Amir7698/desk-clock-pcb/docs/desk-clock-schematic.pdf

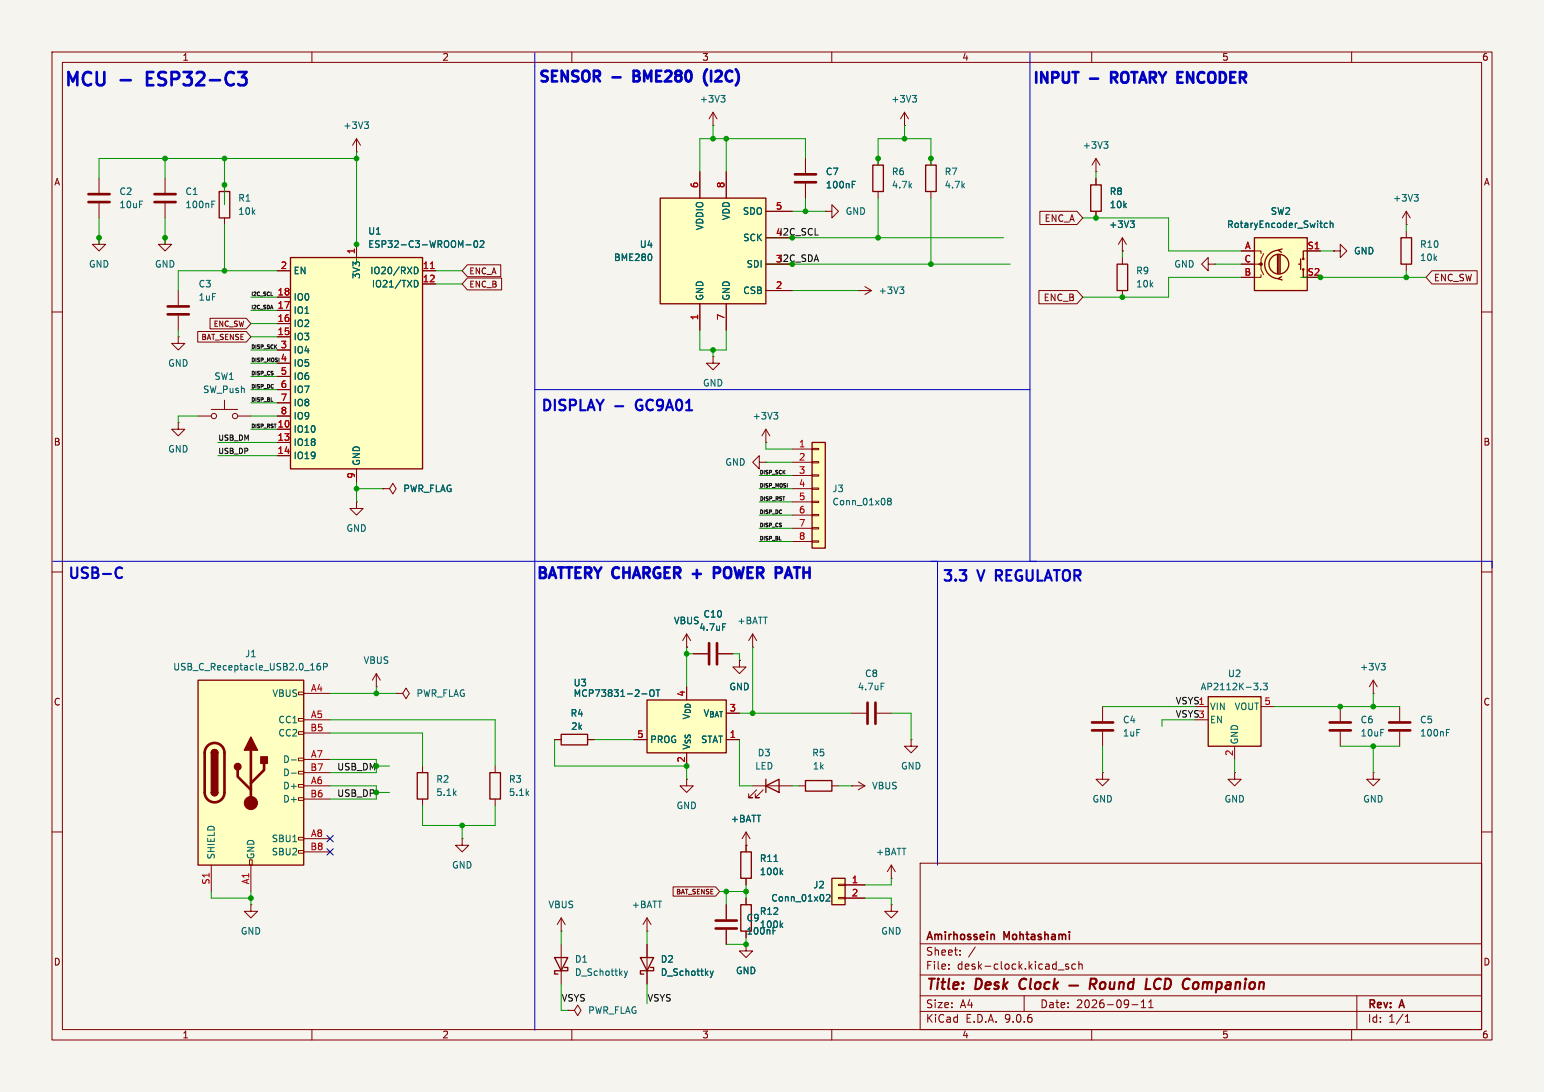
[picture p4: page 1]

7 SDO 5 SCK 4 SDI 3 CSB 2 U4 BME280 R3

7 SDO 5 SCK 4 SDI 3 CSB 2 D2 D_Schottky GND

BATTERY CHARGER + POWER PATH

Id: 1/1 Title: Desk Clock þÿ Round LCD Companion
