Amir7698/desk-clock-pcb/desk-clock.kicad_pcb

## KiCad design desk-clock.kicad_pcb (2026-10-23)

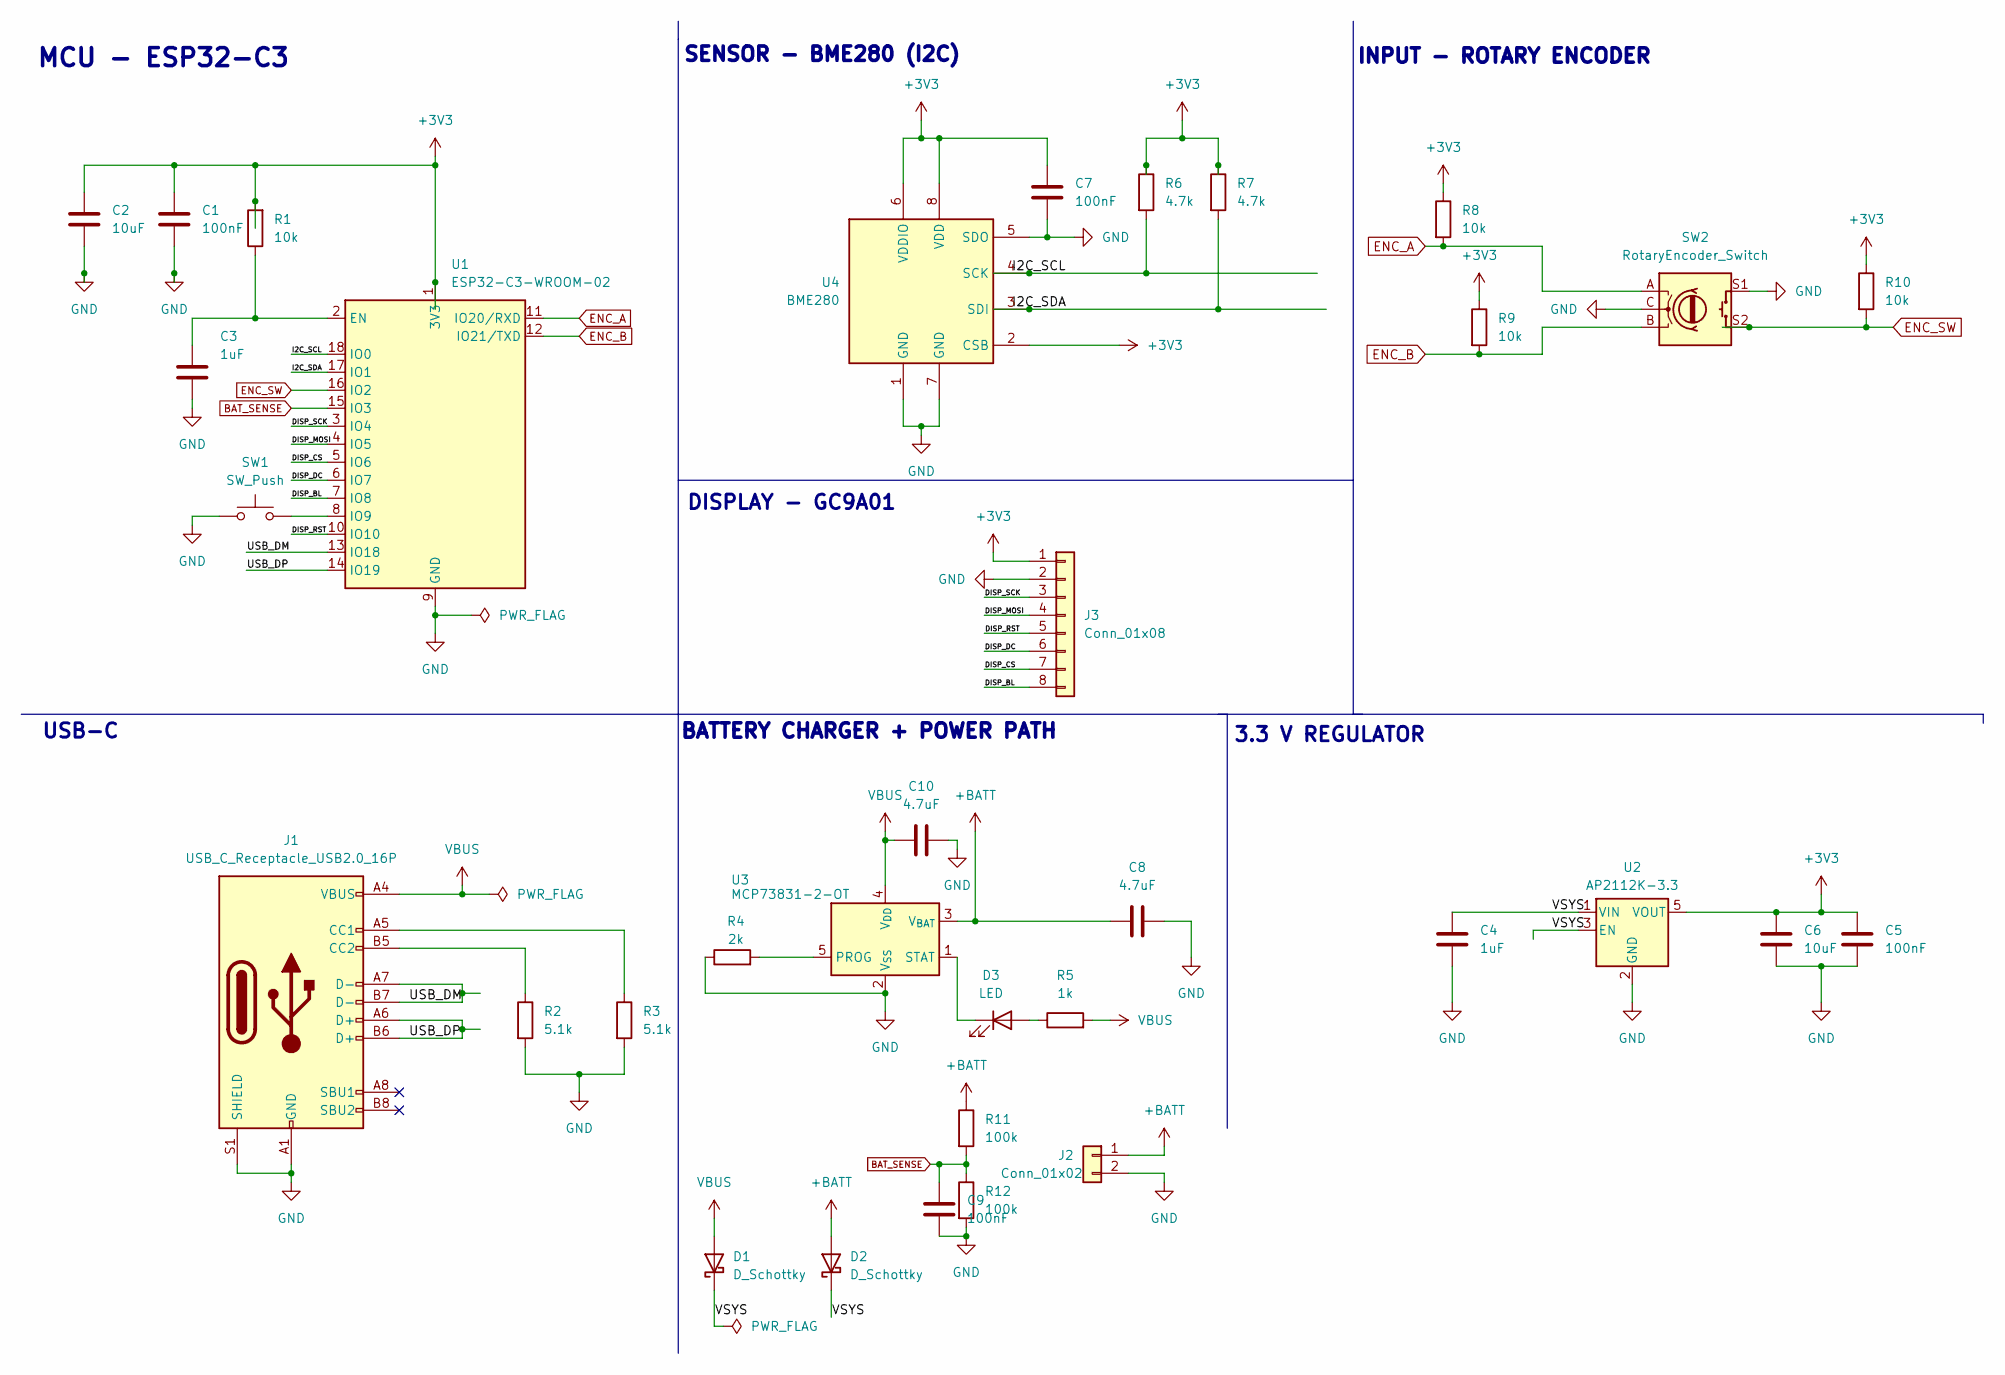
[picture p5: schematic desk-clock.kicad_sch, Desk Clock — Round LCD Companion]

Parts:
C1, C5, C7, C9: 100nF; C_0603_1608Metric
C2, C6: 10uF; C_0805_2012Metric
C3, C4: 1uF; C_0603_1608Metric
C8, C10: 4.7uF; C_0603_1608Metric
D1, D2: D_Schottky; D_SOD-123
D3: LED; LED_0603_1608Metric
J1: USB_C_Receptacle_USB2.0_16P; USB_C_Receptacle_HRO_TYPE-C-31-M-12
J2: Conn_01x02; JST_PH_B2B-PH-K_1x02_P2.00mm_Vertical
J3: Conn_01x08; PinHeader_1x08_P2.54mm_Vertical
R1, R8, R9, R10: 10k; R_0603_1608Metric
R2, R3: 5.1k; R_0603_1608Metric
R4: 2k; R_0603_1608Metric
R5: 1k; R_0603_1608Metric
R6, R7: 4.7k; R_0603_1608Metric
R11, R12: 100k; R_0603_1608Metric
SW1: SW_Push; SW_SPST_TL3342
SW2: RotaryEncoder_Switch; RotaryEncoder_Alps_EC11E-Switch_Vertical_H20mm
U1: ESP32-C3-WROOM-02
U2: AP2112K-3.3; SOT-23-5
U3: MCP73831-2-OT; SOT-23-5
U4: BME280; Bosch_LGA-8_2.5x2.5mm_P0.65mm_ClockwisePinNumbering

Connections:
+3V3: C1.1, C2.1, C5.1, C6.1, C7.1, J3.1, R1.2, R6.1, R7.1, R8.1, R9.1, R10.1, U1.1 (3V3), U2.5 (VOUT), U4.2 (CSB), U4.6 (VDDIO), U4.8 (VDD)
+BATT: C8.1, D2.2 (A), J2.1, R11.1, U3.3 (V_{BAT})
/DISP_BL: J3.8, U1.7 (IO8)
/DISP_CS: J3.7, U1.5 (IO6)
/DISP_DC: J3.6, U1.6 (IO7)
/DISP_MOSI: J3.4, U1.4 (IO5)
/DISP_RST: J3.5, U1.10 (IO10)
/DISP_SCK: J3.3, U1.3 (IO4)
/I2C_SCL: R6.2, U1.18 (IO0), U4.4 (SCK)
/I2C_SDA: R7.2, U1.17 (IO1), U4.3 (SDI)
/USB_DM: J1.A7 (D-), J1.B7 (D-), U1.13 (IO18)
/USB_DP: J1.A6 (D+), J1.B6 (D+), U1.14 (IO19)
/VSYS: C4.1, D1.1 (K), D2.1 (K), U2.1 (VIN), U2.3 (EN)
BAT_SENSE: C9.1, R11.2, R12.1, U1.15 (IO3)
ENC_A: R8.2, SW2.A, U1.11 (IO20/RXD)
ENC_B: R9.2, SW2.B, U1.12 (IO21/TXD)
ENC_SW: R10.2, SW2.S2, U1.16 (IO2)
GND: C1.2, C2.2, C3.2, C4.2, C5.2, C6.2, C7.2, C8.2, C9.2, C10.2, J1.A1 (GND), J1.A12 (GND), J1.B1 (GND), J1.B12 (GND), J1.S1 (SHIELD), J2.2, J3.2, R2.2, R3.2, R4.1, R12.2, SW1.1, SW2.C, SW2.S1, U1.9 (GND), U1.19 (GND), U2.2 (GND), U3.2 (V_{SS}), U4.1 (GND), U4.5 (SDO), U4.7 (GND)
unnamed: D3.2 (A), R5.1
unnamed: D3.1 (K), U3.1 (STAT)
unnamed: J1.A5 (CC1), R3.1
unnamed: J1.B5 (CC2), R2.1
unnamed: C3.1, R1.1, U1.2 (EN)
unnamed: SW1.2, U1.8 (IO9)
unnamed: R4.2, U3.5 (PROG)
VBUS: C10.1, D1.2 (A), J1.A4 (VBUS), J1.A9 (VBUS), J1.B4 (VBUS), J1.B9 (VBUS), R5.2, U3.4 (V_{DD})

Notes on the sheet:
USB-C
MCU - ESP32-C3
DISPLAY - GC9A01
SENSOR - BME280 (I2C)
BATTERY CHARGER + POWER PATH
3.3 V REGULATOR
INPUT - ROTARY ENCODER

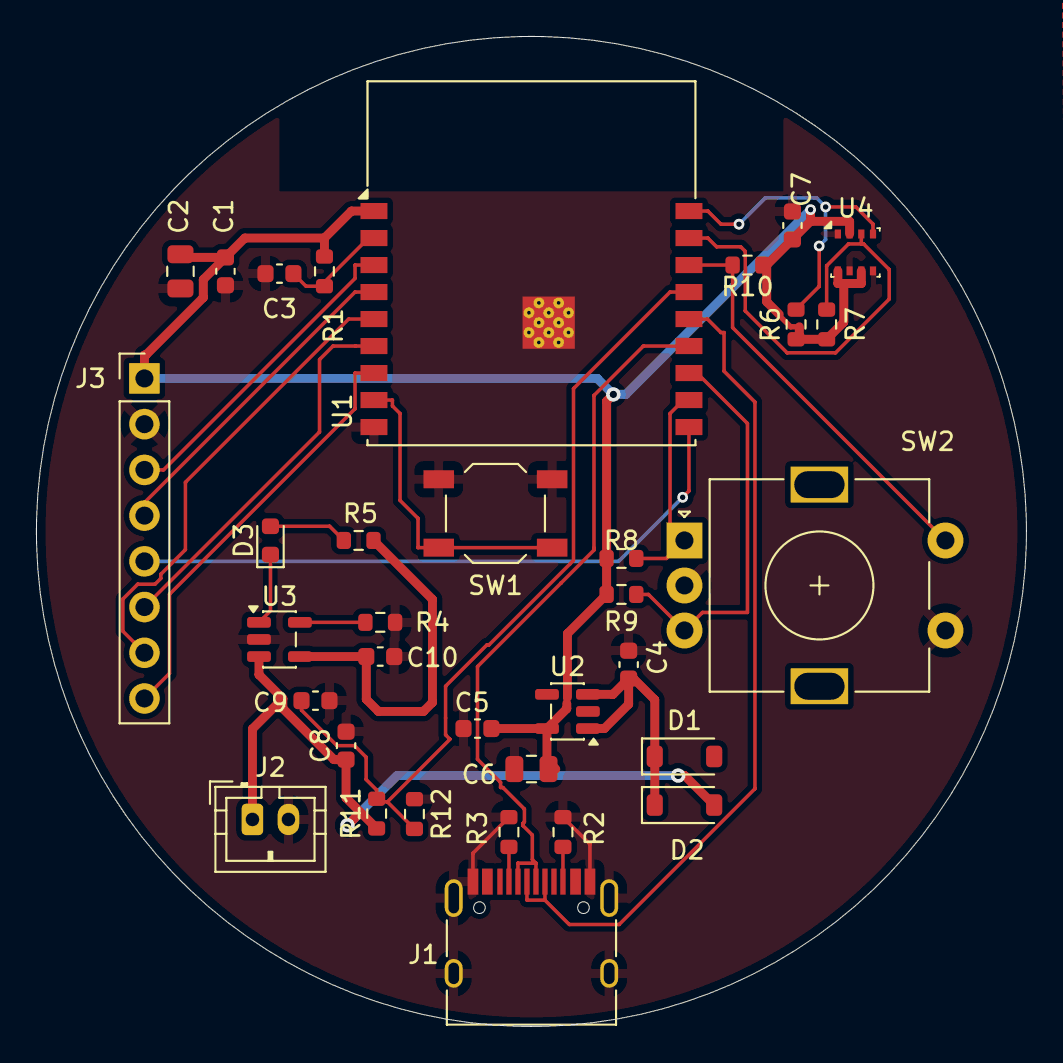
[picture p6: board desk-clock.kicad_pcb from above]

Board: 2 copper layers, 55.0 x 55.0 mm, 34 parts (0 on the bottom side), 26 nets.
