Amir7698/desk-clock-pcb/(commit log)

2026-09-10 Create KiCad 9 project
    [desk-clock.kicad_pcb, desk-clock.kicad_sch]
2026-09-10 Schematic: add ESP32-C3-WROOM-02 module
    [desk-clock.kicad_sch]
2026-09-10 Schematic: module decoupling and EN network
    [desk-clock.kicad_sch]
2026-09-11 Schematic: USB-C input, Li-ion charger, 3.3 V LDO, diode-OR power path, display header, BME280, rotary encoder
    [desk-clock.kicad_sch]
2026-10-03 Schematic: encoder pull-up resistors
    [desk-clock.kicad_sch]
2026-10-22 Schematic complete (ERC clean), footprints assigned; PCB with 55 mm round outline
    [desk-clock.kicad_pcb, desk-clock.kicad_sch]
2026-10-22 PCB: JLCPCB design rules and Power net class
    [desk-clock.kicad_pcb]
2026-10-23 PCB: part placement, GND pours, antenna keep-out, first manual routes
    [desk-clock.kicad_pcb]
2026-10-23 PCB: route power, charger and encoder nets by hand
    [desk-clock.kicad_pcb]
2026-10-23 PCB: FreeRouting pass for the remaining connections
    [desk-clock.kicad_pcb]
2026-10-23 PCB: clean up autorouter output (widen tracks, remove stray vias and stubs)
    [desk-clock.kicad_pcb, desk-clock.kicad_sch]
2026-11-05 Sync board state, add placement scripts and 3D render
2026-11-05 Add 3D renders and schematic PDF, embed them in the README
